BitKnitting/HappyDayNeighbors/Fusion360/rn2483-1.snapshot.1/RN2483.JPG

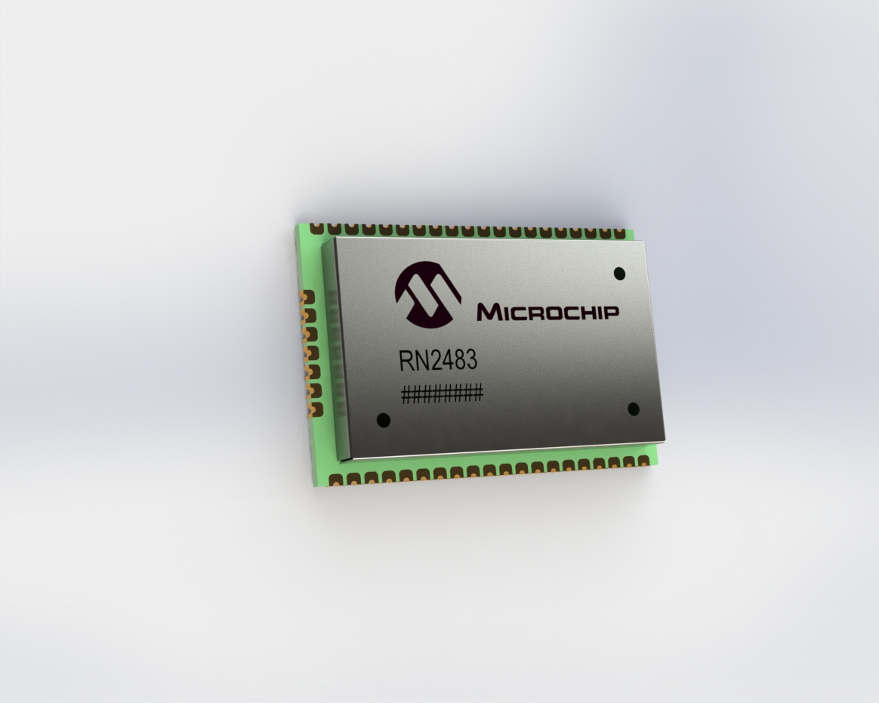
Fusion360/rn2483-1.snapshot.1/RN2483.JPG
