BitKnitting/HappyDayNeighbors/images/ATM90_Circuit.png

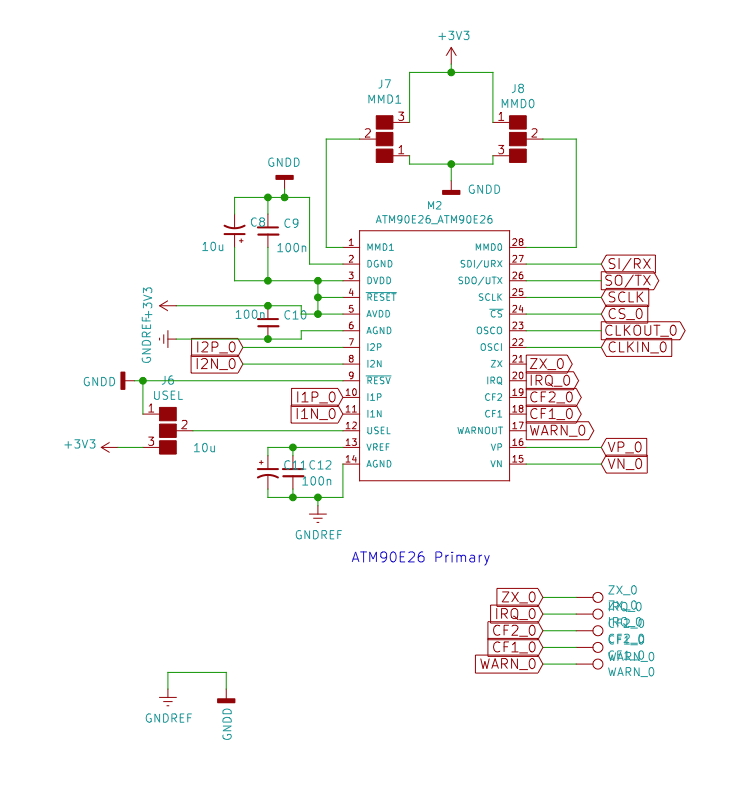
images/ATM90_Circuit.png
