BitKnitting/HappyDayNeighbors/images/AtMelAppNoteSchematic.png

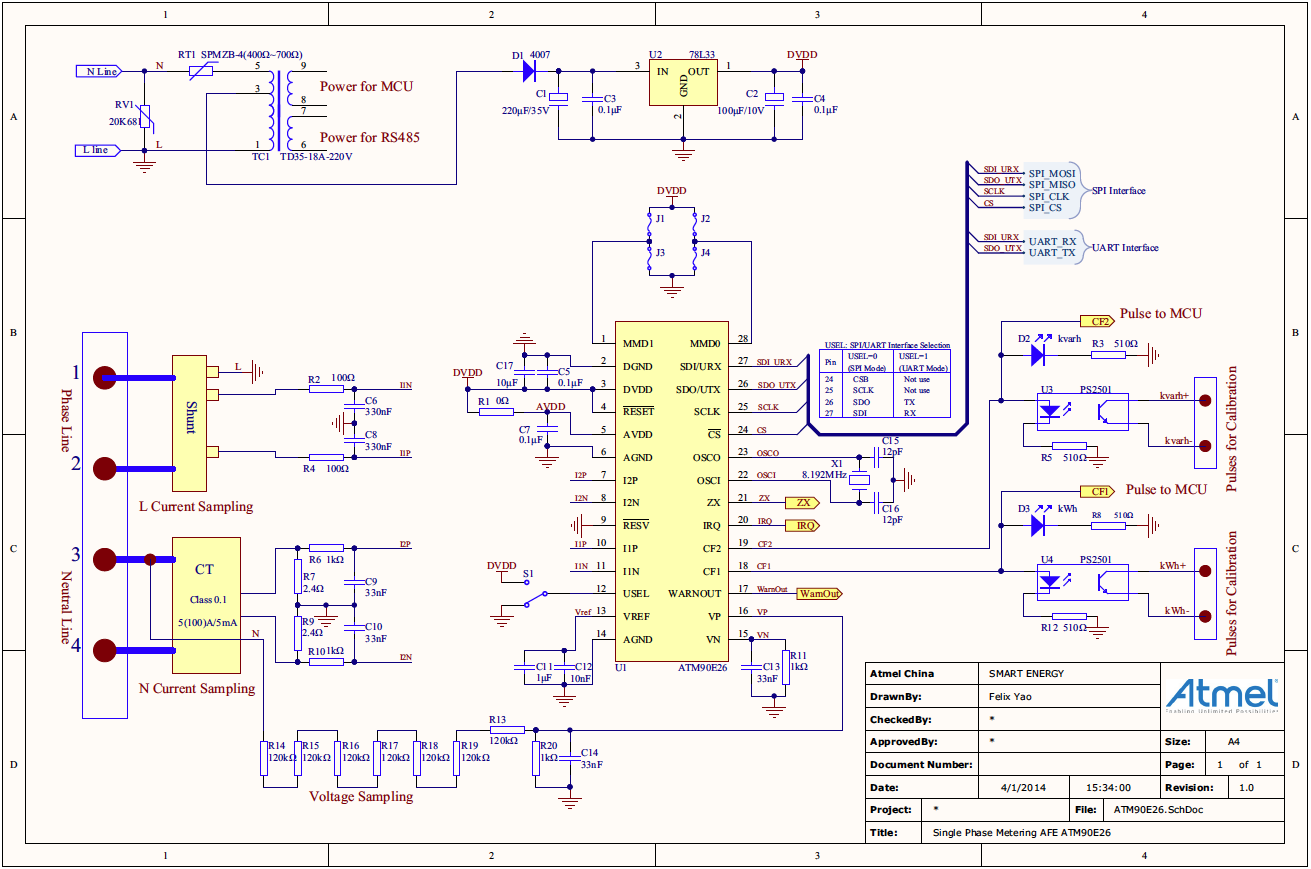
images/AtMelAppNoteSchematic.png
