BitKnitting/HappyDayNeighbors/images/din_power.png

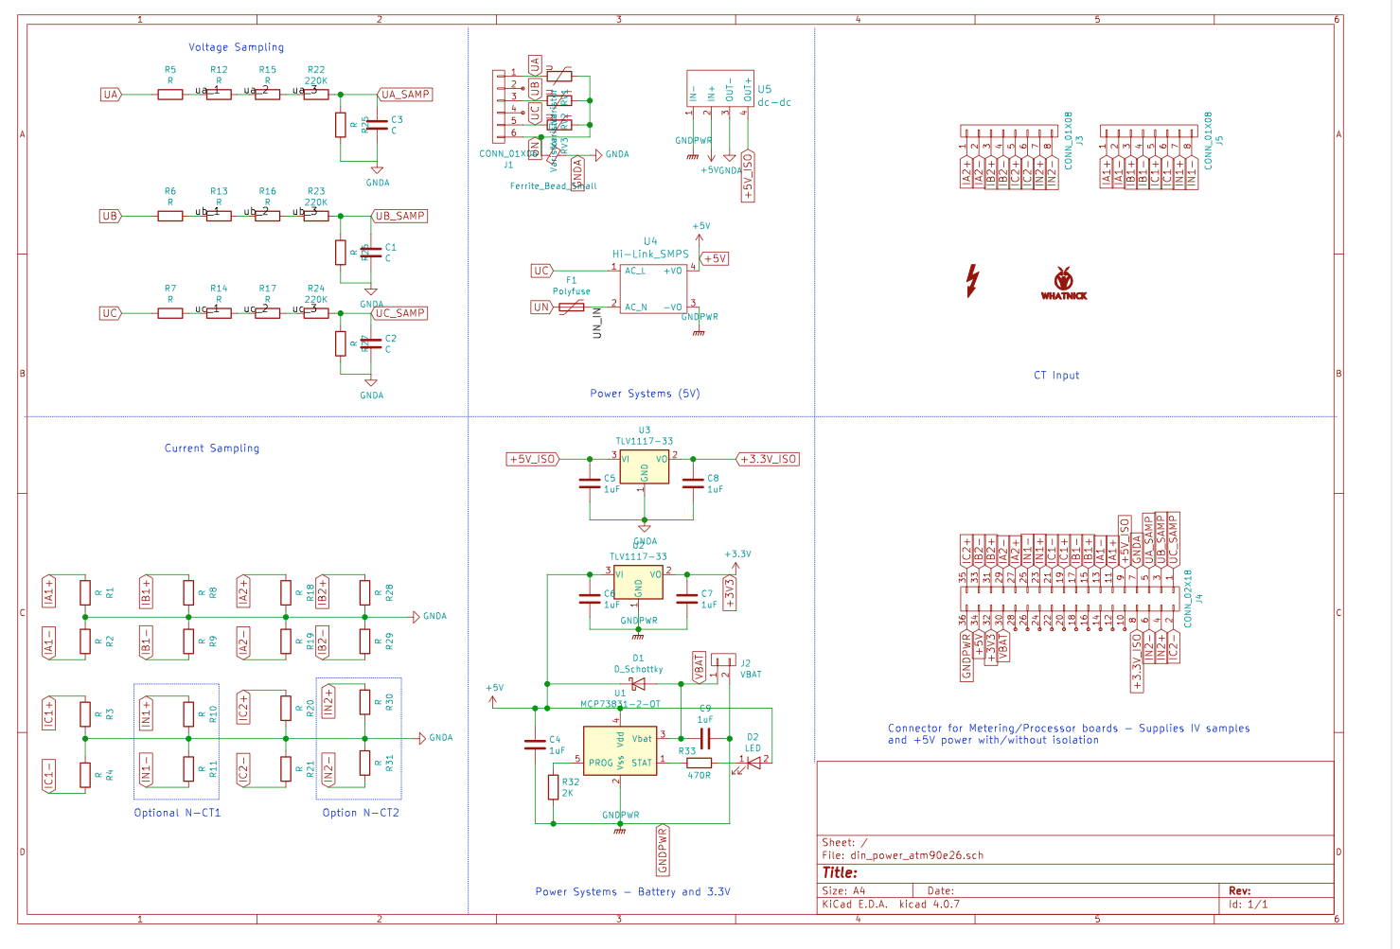
images/din_power.png
