BitKnitting/HappyDayNeighbors/images/HappyDay_IC_Schematic.png

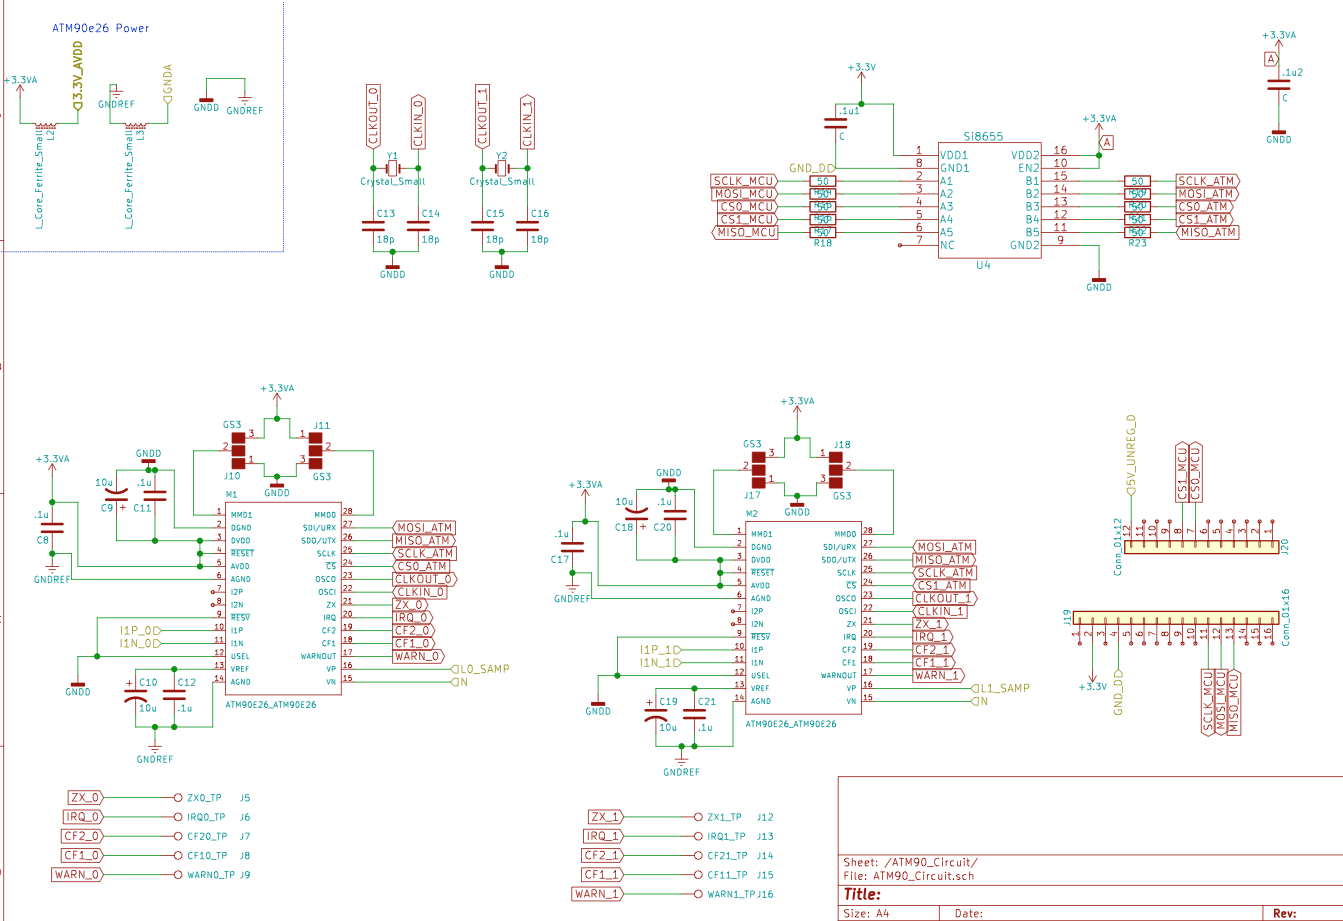
images/HappyDay_IC_Schematic.png
