BitKnitting/HappyDayNeighbors/images/HappyDay_Power_Schematic.png

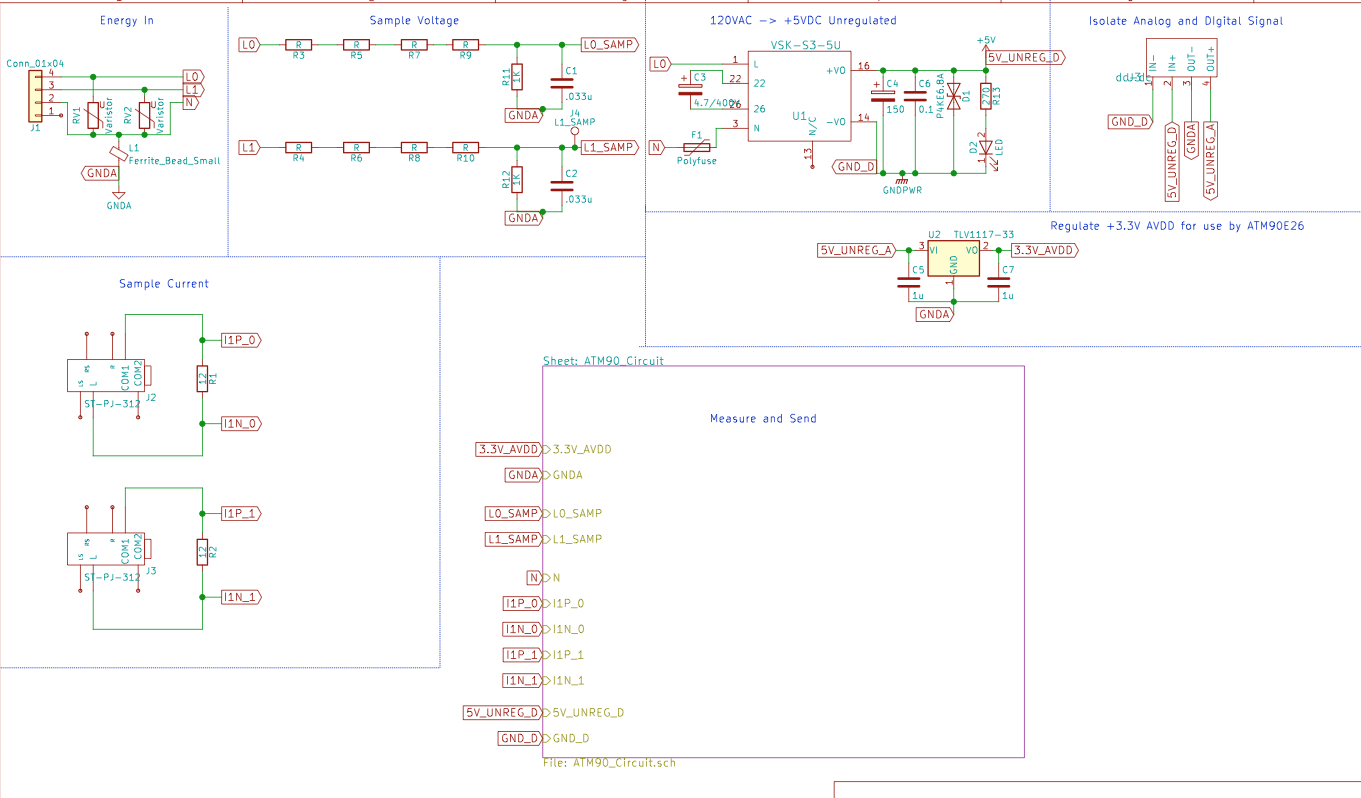
images/HappyDay_Power_Schematic.png
