BitKnitting/HappyDayNeighbors/images/Isolate_analog_and_digital.png

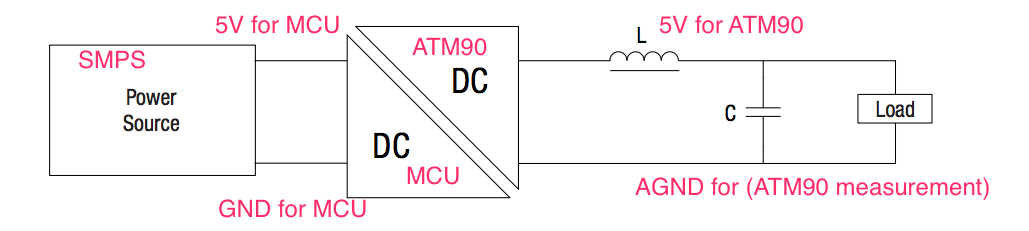
images/Isolate_analog_and_digital.png
