BitKnitting/HappyDayNeighbors/images/OEMPictureElectricityIntoHome.png

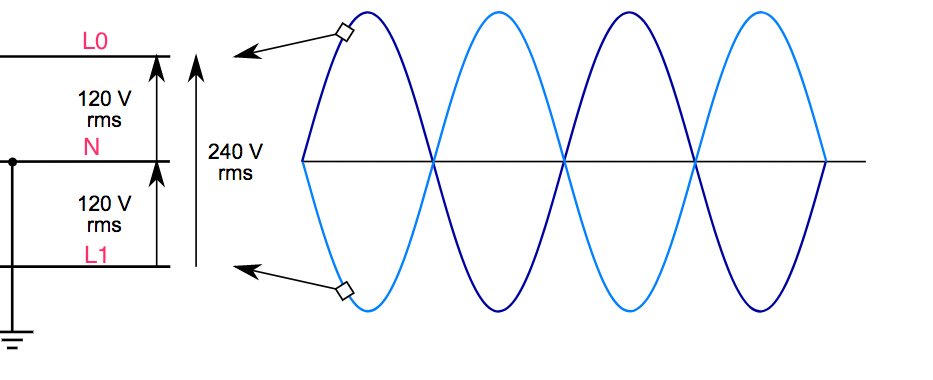
images/OEMPictureElectricityIntoHome.png
