BitKnitting/HappyDayNeighbors/images/ScopeTP3_TP2_LO_SAMP.bmp

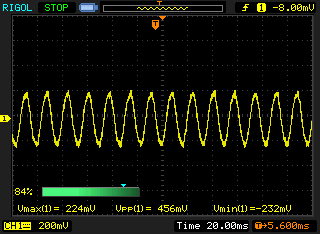
images/ScopeTP3_TP2_LO_SAMP.bmp
