BitKnitting/HappyDayNeighbors/Fusion360/rn2483-1.snapshot.1/RN2483.SLDASM

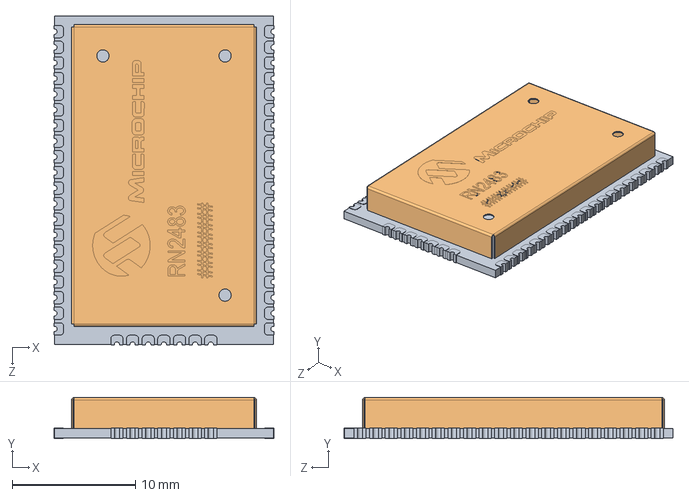
[picture p10: CAD file, 2017-12-04]
Fusion360/rn2483-1.snapshot.1/RN2483.SLDASM
17.9 x 3.35 x 26.7 mm
RN2483-PCB
RN2483-CAN
