BitKnitting/HappyDayNeighbors/Fusion360/rn2483-1.snapshot.1/RN2483-CAN.SLDPRT

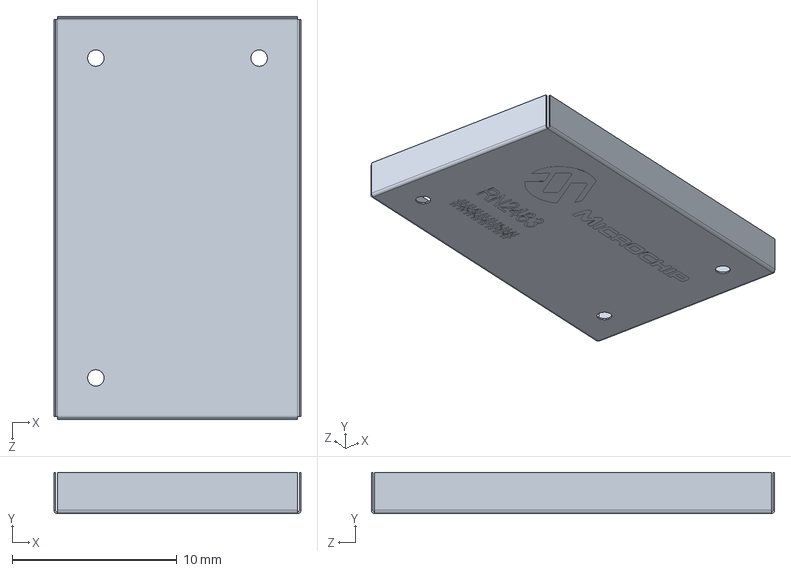
[picture p11: CAD file, 2017-12-04]
Fusion360/rn2483-1.snapshot.1/RN2483-CAN.SLDPRT
15.0 x 2.51 x 24.5 mm
