BitKnitting/HappyDayNeighbors/Fusion360/rn2483-1.snapshot.1/RN2483-PCB.SLDPRT

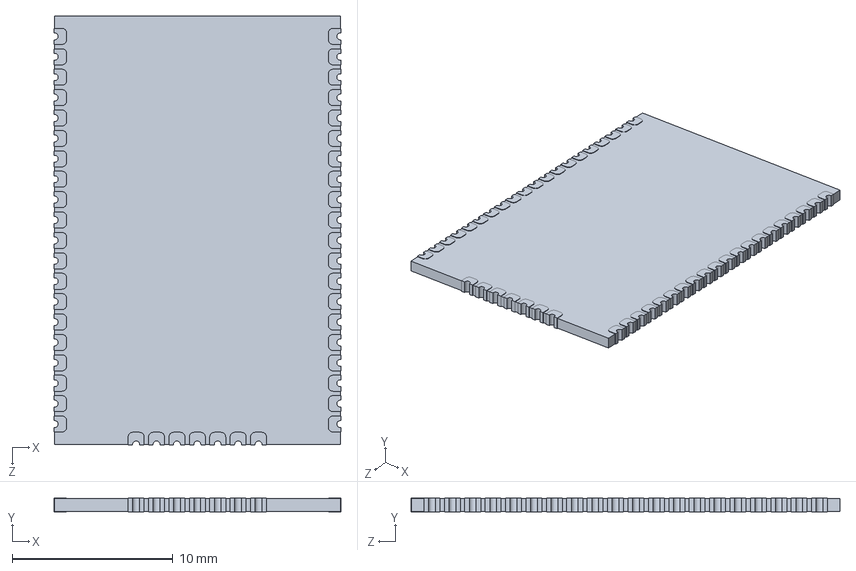
[picture p12: CAD file, 2017-12-04]
Fusion360/rn2483-1.snapshot.1/RN2483-PCB.SLDPRT
17.9 x 0.87 x 26.7 mm
