BitKnitting/HappyDayNeighbors/(list of files, cad)

Other CAD files:
Fusion360/rn2483-1.snapshot.1/RN2483.SLDDRW
