BitKnitting/HappyDayNeighbors/Tools/LogicAnalyzer/Images/ArdspiTestMeterStatusMISO.png

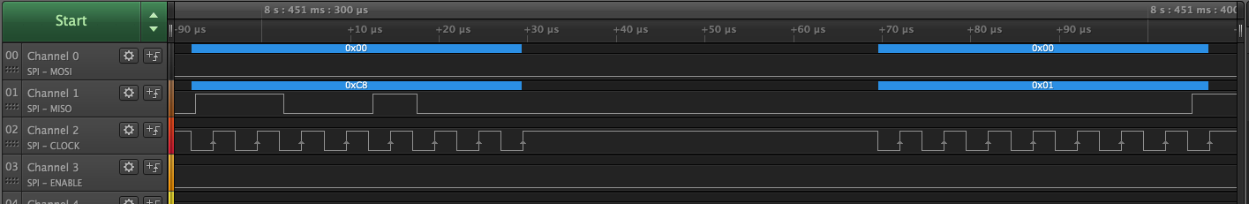
Tools/LogicAnalyzer/Images/ArdspiTestMeterStatusMISO.png
