BitKnitting/HappyDayNeighbors/Tools/LogicAnalyzer/Images/ArdspiTestMeterStatusMOSI.png

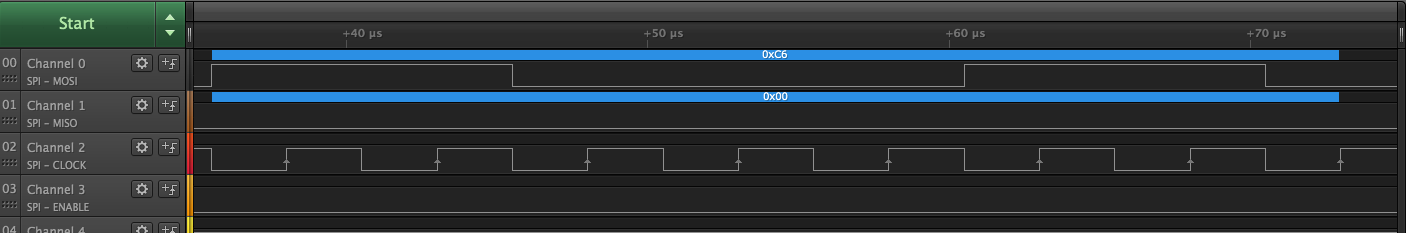
Tools/LogicAnalyzer/Images/ArdspiTestMeterStatusMOSI.png
