BitKnitting/HappyDayNeighbors/Tools/LogicAnalyzer/Images/PyspiTestMeterStatus.png

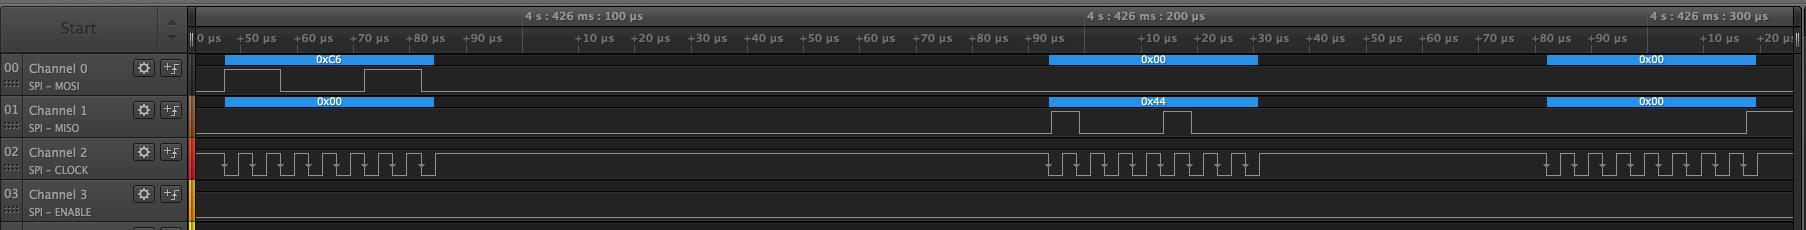
Tools/LogicAnalyzer/Images/PyspiTestMeterStatus.png
