BitKnitting/HappyDayNeighbors/HappyDay_Energy_PCB/HappyDay_Energy_PCB.kicad_pcb

## KiCad design HappyDay_Energy_PCB/HappyDay_Energy_PCB.kicad_pcb (2017-12-27)

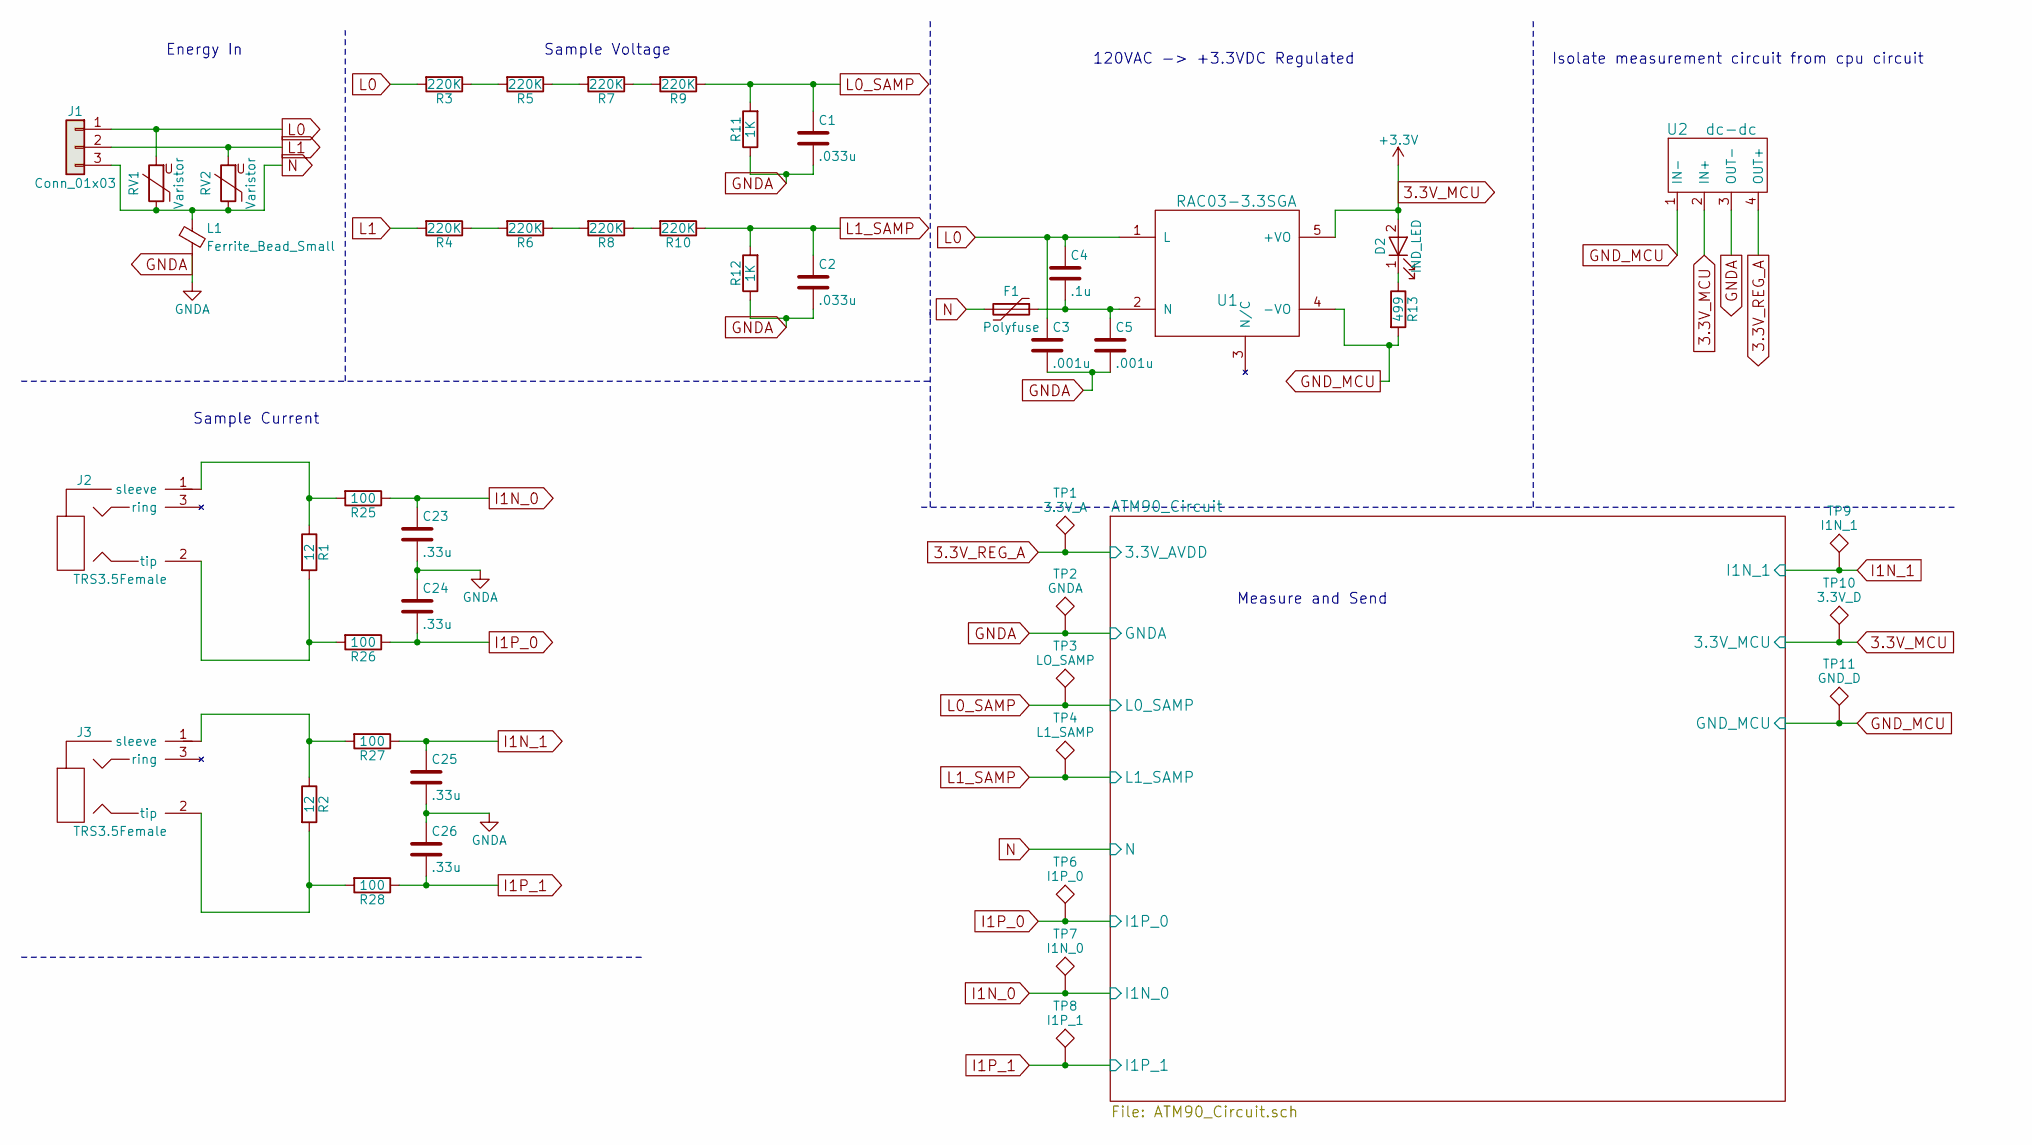
[picture p17: schematic HappyDay_Energy_PCB.sch]

Parts:
C1, C2: .033u; C_0805
C3, C5: .001u; C_0805
C4: .1u; C_0805
C23, C24, C25, C26: .33u; C_0805
D2: IND_LED; C_1206_HandSoldering
F1: Polyfuse; POLYFUSE
J1: Conn_01x03; 3PinConnector
J2, J3: TRS3.5Female; Audio-Jack
L1: Ferrite_Bead_Small; C_1206
R1, R2: 12; C_0805
R3, R4, R5, R6, R7, R8, R9, R10: 220K; C_1206
R11, R12: 1K; C_0805
R13: 499; C_0805
R25, R26, R27, R28: 100; C_0805
RV1, RV2: Varistor; MOV
TP1: 3.3V_A; Test_Point_Pad_d2.0mm
TP2: GNDA; Test_Point_Pad_d2.0mm
TP3: LO_SAMP; Test_Point_Pad_d2.0mm
TP4: L1_SAMP; Test_Point_Pad_d2.0mm
TP6: I1P_0; Test_Point_Pad_d2.0mm
TP7: I1N_0; Test_Point_Pad_d2.0mm
TP8: I1P_1; Test_Point_Pad_d2.0mm
TP9: I1N_1; Test_Point_Pad_d2.0mm
TP10: 3.3V_D; Test_Point_Pad_d2.0mm
TP11: GND_D; Test_Point_Pad_d2.0mm
U1: RAC03-3.3SGA; RAC03-GA
U2: dc-dc; DC-DC

Connections:
3.3V_MCU: D2.2 (A), TP10.1, U1.5 (+VO), U2.2 (IN+); also elsewhere on the board
3.3V_REG_A: TP1.1, U2.4 (OUT+); also elsewhere on the board
GNDA: C1.2, C2.2, C3.2, C5.2, C23.2, C24.1, C25.2, C26.1, L1.2, R11.1, R12.1, TP2.1, U2.3 (OUT-); also elsewhere on the board
GND_MCU: R13.2, TP11.1, U1.4 (-VO), U2.1 (IN-); also elsewhere on the board
I1N_0: C23.1, R25.1, TP7.1; also elsewhere on the board
I1N_1: C25.1, R27.1, TP9.1; also elsewhere on the board
I1P_0: C24.2, R26.1, TP6.1; also elsewhere on the board
I1P_1: C26.2, R28.1, TP8.1; also elsewhere on the board
L0: C3.1, C4.1, J1.1, R3.2, RV1.2, U1.1 (L)
L0_SAMP: C1.1, R9.1, R11.2, TP3.1; also elsewhere on the board
L1: J1.2, R4.2, RV2.2
L1_SAMP: C2.1, R10.1, R12.2, TP4.1; also elsewhere on the board
N: F1.2, J1.3, L1.1, RV1.1, RV2.1; also elsewhere on the board
unnamed: C4.2, C5.1, F1.1, U1.2 (N)
unnamed: D2.1 (K), R13.1
unnamed: J2.1 (sleeve), R1.1, R25.2
unnamed: J2.2 (tip), R1.2, R26.2
unnamed: J3.1 (sleeve), R2.1, R27.2
unnamed: J3.2 (tip), R2.2, R28.2
unnamed: R3.1, R5.2
unnamed: R4.1, R6.2
unnamed: R5.1, R7.2
unnamed: R6.1, R8.2
unnamed: R7.1, R9.2
unnamed: R8.1, R10.2

Notes on the sheet:
Energy In
Sample Voltage
Sample Current
120VAC -> +3.3VDC Regulated
Isolate measurement circuit from cpu circuit
Measure and Send

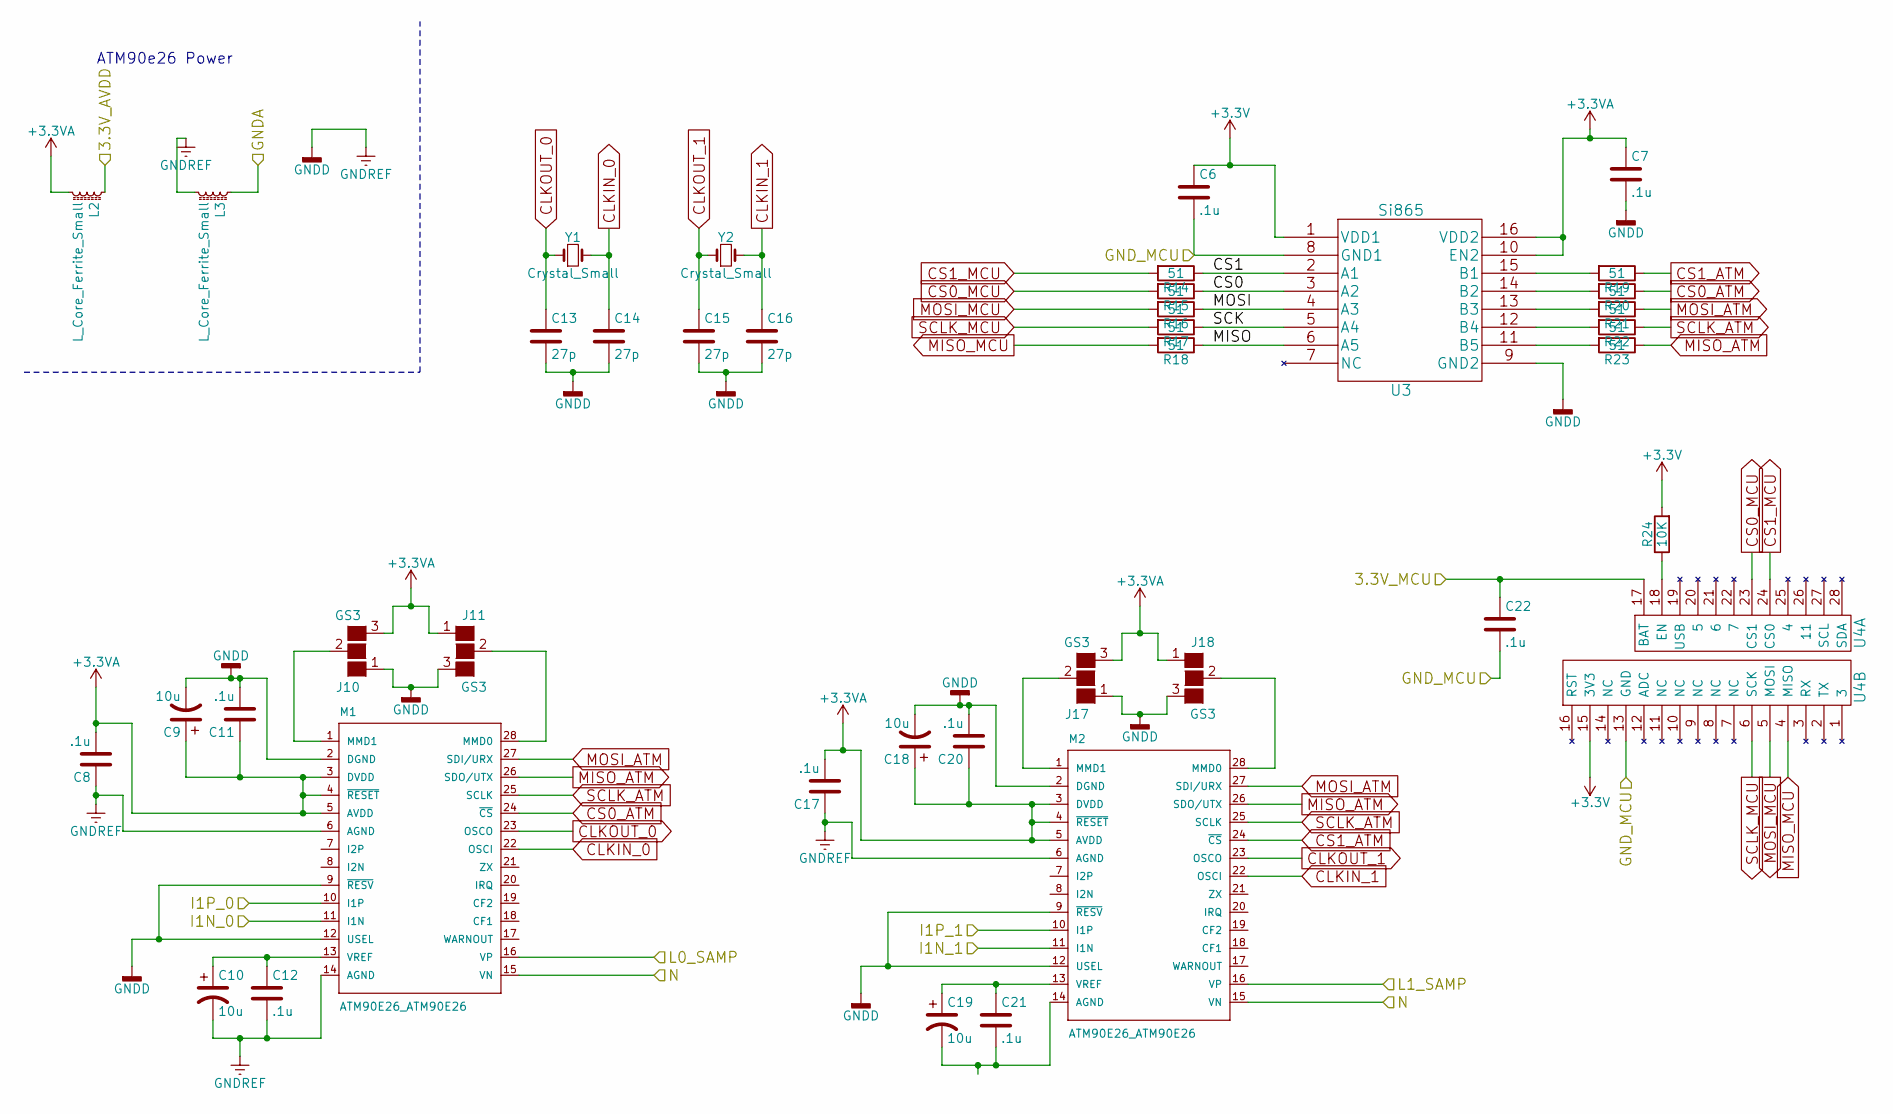
[picture p18: schematic ATM90_Circuit.sch]

Parts:
C6, C7, C8, C11, C12, C17, C20, C21, C22: .1u; C_0805
C9, C10, C18, C19: 10u; C_0805
C13, C14, C15, C16: 27p; C_0805
J10, J11, J17, J18: GS3
L2, L3: L_Core_Ferrite_Small; C_0805
M1, M2: ATM90E26_ATM90E26; SSOP-28_5.3x10.2mm_Pitch0.65mm
R14, R15, R16, R17, R18, R19, R20, R21, R22, R23: 51; C_0805
R24: 10K; C_0805
U3: Si865
U4: FeatherHuzzah; ADAFRUIT_FEATHER
Y1, Y2: Crystal_Small; Crystal

Connections:
3.3V_MCU: C6.1, C22.1, R24.2, U3.1 (VDD1), U4.15 (3V3), U4.17 (BAT); also elsewhere on the board
3.3V_REG_A: L2.1; also elsewhere on the board
+3.3VA: C7.1, C8.2, C9.1, C11.1, C17.2, C18.1, C20.1, J10.3 (G3), J11.1 (G1), J17.3 (G3), J18.1 (G1), L2.2, M1.3 (DVDD), M1.4 (~RESET), M1.5 (AVDD), M2.3 (DVDD), M2.4 (~RESET), M2.5 (AVDD), U3.10 (EN2), U3.16 (VDD2)
/ATM90_Circuit/CS0: R15.1, U3.3 (A2)
/ATM90_Circuit/CS1: R14.1, U3.2 (A1)
/ATM90_Circuit/MISO: R18.1, U3.6 (A5)
/ATM90_Circuit/MOSI: R16.1, U3.4 (A3)
/ATM90_Circuit/SCK: R17.1, U3.5 (A4)
CLKIN_0: C14.1, M1.22 (OSCI), Y1.2
CLKIN_1: C16.1, M2.22 (OSCI), Y2.2
CLKOUT_0: C13.1, M1.23 (OSCO), Y1.1
CLKOUT_1: C15.1, M2.23 (OSCO), Y2.1
CS0_ATM: M1.24 (~CS), R20.1
CS0_MCU: R15.2, U4.23 (CS1)
CS1_ATM: M2.24 (~CS), R19.1
CS1_MCU: R14.2, U4.24 (CS0)
GNDA: L3.1; also elsewhere on the board
GNDD: C7.2, C8.1, C9.2, C10.2, C11.2, C12.2, C13.2, C14.2, C15.2, C16.2, C17.1, C18.2, C20.2, J10.1 (G1), J11.3 (G3), J17.1 (G1), J18.3 (G3), L3.2, M1.2 (DGND), M1.6 (AGND), M1.9 (~RESV), M1.12 (USEL), M1.14 (AGND), M2.2 (DGND), M2.6 (AGND), M2.9 (~RESV), M2.12 (USEL), U3.9 (GND2)
GND_MCU: C6.2, C22.2, U3.8 (GND1), U4.13 (GND); also elsewhere on the board
I1N_0: M1.11 (I1N); also elsewhere on the board
I1N_1: M2.11 (I1N); also elsewhere on the board
I1P_0: M1.10 (I1P); also elsewhere on the board
I1P_1: M2.10 (I1P); also elsewhere on the board
L0_SAMP: M1.16 (VP); also elsewhere on the board
L1_SAMP: M2.16 (VP); also elsewhere on the board
MISO_ATM: M1.26 (SDO/UTX), M2.26 (SDO/UTX), R23.1
MISO_MCU: R18.2, U4.4 (MISO)
MOSI_ATM: M1.27 (SDI/URX), M2.27 (SDI/URX), R21.1
MOSI_MCU: R16.2, U4.5 (MOSI)
N: M1.15 (VN), M2.15 (VN); also elsewhere on the board
unnamed: C10.1, C12.1, M1.13 (VREF)
unnamed: C19.1, C21.1, M2.13 (VREF)
unnamed: C19.2, C21.2, M2.14 (AGND)
unnamed: J10.2 (G2), M1.1 (MMD1)
unnamed: J11.2 (G2), M1.28 (MMD0)
unnamed: J17.2 (G2), M2.1 (MMD1)
unnamed: J18.2 (G2), M2.28 (MMD0)
unnamed: R19.2, U3.15 (B1)
unnamed: R20.2, U3.14 (B2)
unnamed: R21.2, U3.13 (B3)
unnamed: R22.2, U3.12 (B4)
unnamed: R23.2, U3.11 (B5)
unnamed: R24.1, U4.18 (EN)
SCLK_ATM: M1.25 (SCLK), M2.25 (SCLK), R22.1
SCLK_MCU: R17.2, U4.6 (SCK)

Notes on the sheet:
ATM90e26 Power

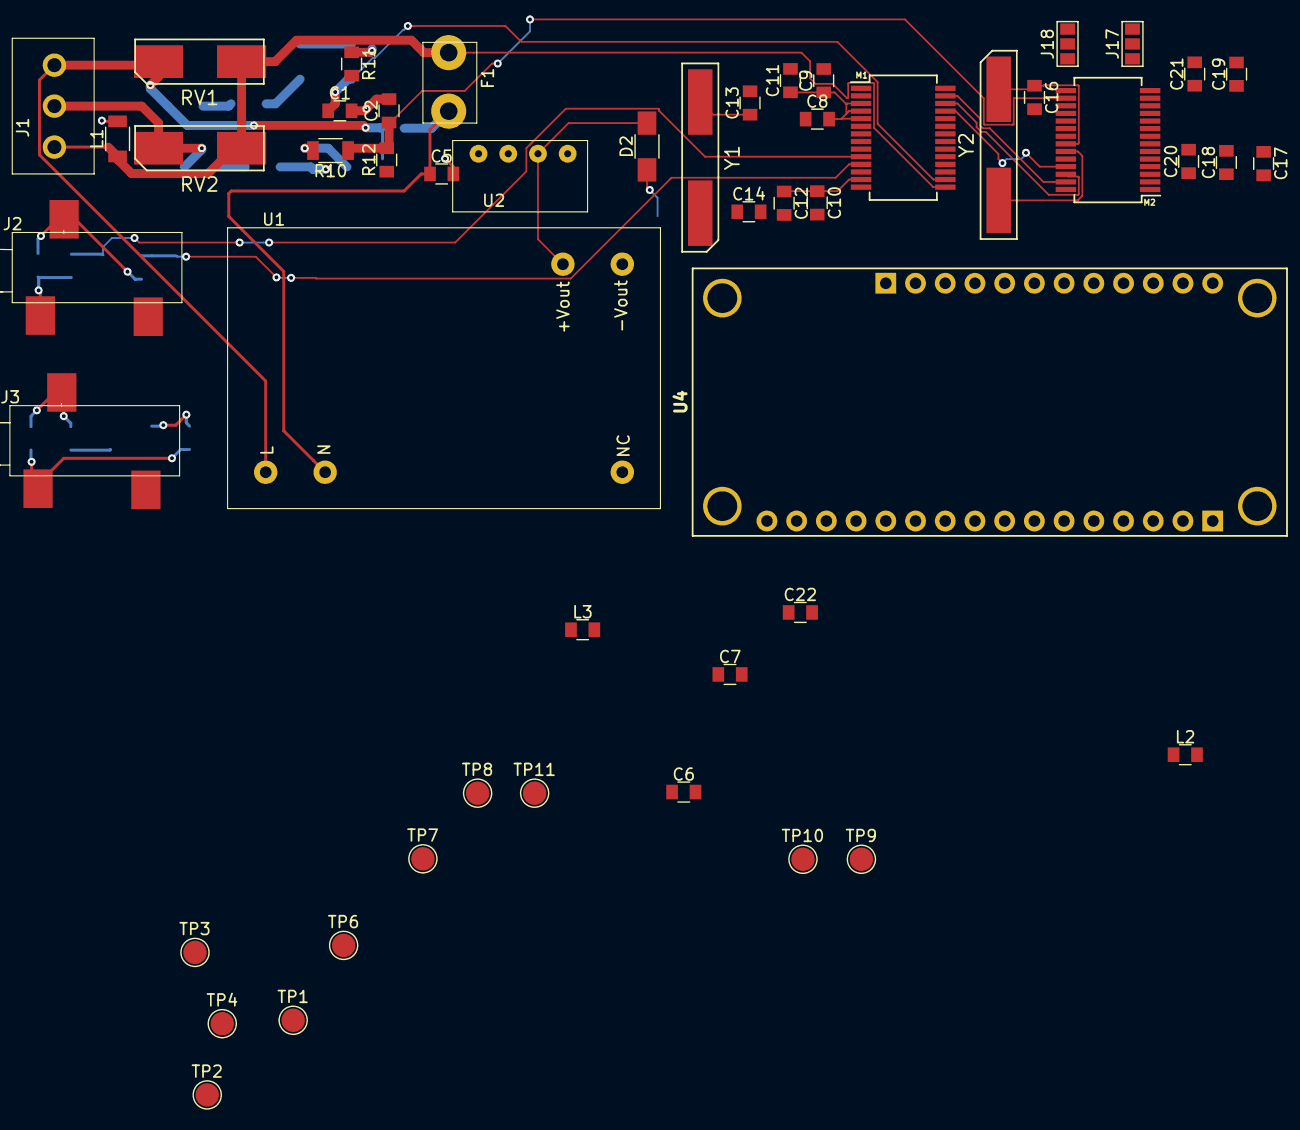
[picture p19: board HappyDay_Energy_PCB.kicad_pcb from above]

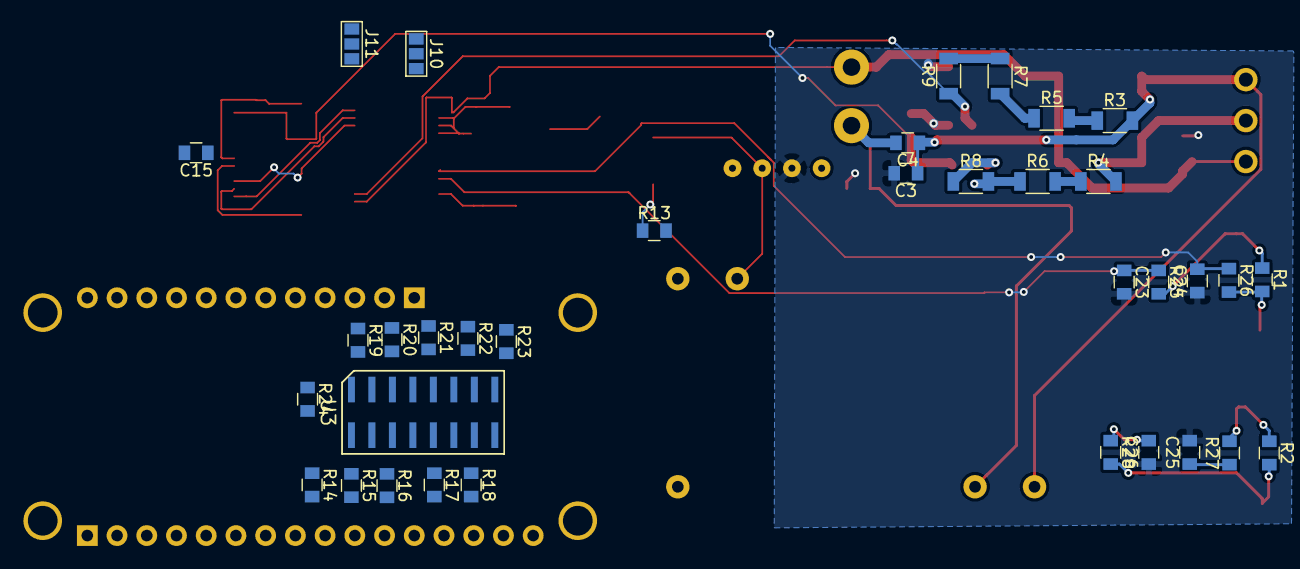
[picture p20: board HappyDay_Energy_PCB.kicad_pcb from below]

Board: 2 copper layers, 86 parts (35 on the bottom side), 59 nets.
