BitKnitting/HappyDayNeighbors/Python/refresh_Huzzah/HappyDay_energyic_spi.py

# The MIT License (MIT)
#
# Copyright (c) 2017 HappyDay
#
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
# THE SOFTWARE IS PROVIDED "AS IS", WITHOUT WARRANTY OF ANY KIND, EXPRESS OR
# IMPLIED, INCLUDING BUT NOT LIMITED TO THE WARRANTIES OF MERCHANTABILITY,
# FITNESS FOR A PARTICULAR PURPOSE AND NONINFRINGEMENT. IN NO EVENT SHALL THE
# AUTHORS OR COPYRIGHT HOLDERS BE LIABLE FOR ANY CLAIM, DAMAGES OR OTHER
# LIABILITY, WHETHER IN AN ACTION OF CONTRACT, TORT OR OTHERWISE, ARISING FROM,
# OUT OF OR IN CONNECTION WITH THE SOFTWARE OR THE USE OR OTHER DEALINGS IN
# THE SOFTWARE.
"""
`HappyDay_energyic_SPI`
====================================================

This is a CircuitPython driver for the ATM90e26 energy reading chip.

* Author(s): HappyDay ported the energyic_SPI.cpp Arduino library by whatnick and
             Ryzee (c 2016).  The energyic_SPI.cpp library is located at this GitHub location:
             https://github.com/whatnick/ATM90E26_Arduino/blob/master/energyic_SPI.cpp
             The HappyDay port is copyright 2017.

"""
#### REGISTERS #####
ATM90_SysStatus    = const(0x01)  # System Status
ATM90_SoftReset    = const(0x00)  # Software Reset
ATM90_FuncEn       = const(0x02)  # Function Enable
ATM90_SagTh        = const(0x03)  # Voltage Sag Threshold
ATM90_CalStart     = const(0x20)  # Calibration Start Command
ATM90_PLconstH     = const(0x21)  # High Word of PL_Constant
ATM90_PLconstL     = const(0x22)  # Low Word of PL_Constant
ATM90_Lgain        = const(0x23)  # L Line Calibration Gain
ATM90_Lphi         = const(0x24)  # L Line Calibration Angle
ATM90_Ngain        = const(0x25)  # N Line Calibration Gain
ATM90_Nphi         = const(0x26)  # N Line Calibration Angle
ATM90_PStartTh     = const(0x27)  # Active Startup Power Threshold
ATM90_PNolTh       = const(0x28)  # Active No-Load Power Threshold
ATM90_QStartTh     = const(0x29)  # Reactive Startup Power Threshold
ATM90_QNolTh       = const(0x2A)  # Reactive No-Load Power Threshold
ATM90_MMode        = const(0x2B)  # Metering Mode Configuration
ATM90_CSOne        = const(0x2C)  # Checksum 1
ATM90_AdjStart     = const(0x30)  # Measurement calibration startup command, registers 31-3A
ATM90_Ugain        = const(0x31)  # Voltage rms Gain
ATM90_IgainL       = const(0x32)  # L Line Current rms Gain
ATM90_Uoffset      = const(0x34)  # Voltage Offset
ATM90_IoffsetL     = const(0x35)  # L line current offset
ATM90_PoffsetL     = const(0x37)  # L Line Active Power Offset
ATM90_QoffsetL     = const(0x38)  # L Line Reactive Power Offset
ATM90_CSTwo        = const(0x3B)  # Checksum 2
ATM90_EnStatus     = const(0x46)  # Metering Status
ATM90_Urms         = const(0x49)  # Voltage rms
ATM90_Irms         = const(0x48)  # L Line Current rms
ATM90_Pmean        = const(0x4A)  # L Line Mean Active Power
ATM90_PowerF       = const(0x4D)  # L Line Power Factor
ATM90_Freq         = const(0x4C)  # Voltage frequency
ATM90_APenergy     = const(0x40)  # Forward Active Energy
ATM90_ANenergy     = const(0x41)  # Reverse Active Energy

import time # need a bit of delay at the end of initializing the ATM90e26...
import board
import busio
import digitalio
from spi_device import SPIDevice

class energyic_SPI:
    ##############################################################################

    def __init__(self,spi_bus,cs):
        self._device = SPIDevice(spi_bus,cs,baudrate=200000,polarity=1,phase=1)

    def initEnergyIC(self):
        # Perform soft reset
        self._commEnergyIC(0,ATM90_SoftReset,0x789A)
        # Voltage sag irq=1, report on warnout pin=1, energy dir change irq=0
        self._commEnergyIC(0,ATM90_FuncEn,0x0030)
        # Voltage sag threshhold
        self._commEnergyIC(0,ATM90_SagTh,0x1F2F)
        #########################################
        #### Set metering calibration values ####
        #########################################
        # Metering calibration startup command. Register 21 to 2B need to be set
        self._commEnergyIC(0,ATM90_CalStart,0x5678)
        # PL Constant MSB
        self._commEnergyIC(0,ATM90_PLconstH,0x00B9)
        # PL Constant LSB
        self._commEnergyIC(0,ATM90_PLconstL,0xC1F3)
        # Line calibration gain
        self._commEnergyIC(0,ATM90_Lgain,0x1D39)
        # Line calibration angle
        self._commEnergyIC(0,ATM90_Lphi,0x0000)
        # Active Startup Power Threshold
        self._commEnergyIC(0,ATM90_PStartTh,0x08BD)
        # Active No-Load Power Threshold
        self._commEnergyIC(0,ATM90_PNolTh,0x0000)
        # Reactive Startup Power Threshold
        self._commEnergyIC(0,ATM90_QStartTh,0x0AEC)
        # Reactive No-Load Power Threshold
        self._commEnergyIC(0,ATM90_QNolTh,0x0000)
        # Metering Mode Configuration. All defaults. See pg 3
        self._commEnergyIC(0,ATM90_MMode,0x9422)
        # Write CSOne, as self calculated
        self._commEnergyIC(0,ATM90_CSOne,0x4A34)
        #checksum = self._commEnergyIC(1,ATM90_CSOne,0x0000)
        #print('Checksum 1: ',hex(checksum))
        ##############################################
        # Set measurement calibration values
        ##############################################
        self._commEnergyIC(0,ATM90_AdjStart,0x5678)
        #!!!!!!!!!!!!!!!!!!!!!!!!!!!!!!!!!!!!!!!!!!!!!!!!!!!!!!!!!!!!!!!!!!!!!!!!!!!!!!!!!!!
        ### !!!!! Modified Ugain.  See my bitknitting post on this:
        # https://bitknitting.wordpress.com/2017/10/07/trying-out-the-atm90e26-featherwing/
        #!!!!!!!!!!!!!!!!!!!!!!!!!!!!!!!!!!!!!!!!!!!!!!!!!!!!!!!!!!!!!!!!!!!!!!!!!!!!!!!!!!!
        self._commEnergyIC(0,ATM90_Ugain,0x890F)
        # L line current gain
        self._commEnergyIC(0,ATM90_IgainL,0x6E49)
        # Voltage offset
        self._commEnergyIC(0,ATM90_Uoffset,0x0000)
        # L line current offset
        self._commEnergyIC(0,ATM90_IoffsetL,0x0000)
        # L line active power offset
        self._commEnergyIC(0,ATM90_PoffsetL,0x0000)
        # L line reactive power offset
        self._commEnergyIC(0,ATM90_QoffsetL,0x0000)
        #!!!!!!!!!!!!!!!!!!!!!!!!!!!!!!!!!!!!!!!!!!!!!!!!!!!!!!!!!!!!!!!!!!!!!!!!!!!!!!!!!!!
        ### !!!!! Modified Checksum two.  See my bitknitting post on this:
        # https://bitknitting.wordpress.com/2017/10/07/trying-out-the-atm90e26-featherwing/
        #!!!!!!!!!!!!!!!!!!!!!!!!!!!!!!!!!!!!!!!!!!!!!!!!!!!!!!!!!!!!!!!!!!!!!!!!!!!!!!!!!!!
        self._commEnergyIC(0,ATM90_CSTwo,0xE4F4)
        #checksum = self._commEnergyIC(1,ATM90_CSTwo,0x0000)
        #print('Checksum 2: ',hex(checksum))
        # Checks correctness of 21-2B registers and starts normal metering if ok
        self._commEnergyIC(0,ATM90_CalStart,0x8765)
        # Checks correctness of 31-3A registers and starts normal measurement  if ok
        self._commEnergyIC(0,ATM90_AdjStart,0x8765)
        time.sleep(2) # the chip needs a couple of secs to get it's act together.....
        #####################################################################################
    def getSysStatus(self):
        reading = self._commEnergyIC(1,ATM90_SysStatus,0xFFFF)
        return reading
        #####################################################################################
    def getMeterStatus(self):
        reading = self._commEnergyIC(1,ATM90_EnStatus,0xFFFF)
        return reading
        #####################################################################################
    def getLineVoltage(self):
        reading = self._commEnergyIC(1,ATM90_Urms,0xFFFF)
        reading = reading/100.0
        return reading
        #####################################################################################
    def getLineCurrent(self):
        reading = self._commEnergyIC(1,ATM90_Irms,0xFFFF)
        print("line current: ",reading)
        reading = reading/1000
        return reading
        #####################################################################################
    def getActivePower(self):
        reading = self._commEnergyIC(1,ATM90_Pmean,0xFFFF)
        return reading
        #####################################################################################
    def getPowerFactor(self):
        reading = self._commEnergyIC(1,ATM90_PowerF,0xFFFF)
        # MSB is signed bit...if negative...
        if (reading & 0x8000):
            reading = (reading & 0x7FFF) * -1
        return reading/1000
        #####################################################################################
    def getFrequency(self):
        reading = self._commEnergyIC(1,ATM90_Freq,0xFFFF)
        return reading/100
        #####################################################################################
    def getImportEnergy(self):
        reading = self._commEnergyIC(1,ATM90_APenergy,0xFFFF)
        return reading * 0.0001 # returns kWh if PL constant set to 1000imp/kWh
        #####################################################################################
    def getExportEnergy(self):
        reading = self._commEnergyIC(1,ATM90_ANenergy,0xFFFF)
        return reading * 0.0001 # returns kWh if PL constant set to 1000imp/kWh
        #####################################################################################
    def _commEnergyIC(self,RW,address,value):
        #####################################################################################
        # If RW = Read, There needs to be a 1 in the highest bit of the address
        address |= RW << 7
        # The Arduino library put us sleeps in...I was getting correct results without adding sleeps???
        #usleep = lambda x: time.sleep(x/1000000.0)
        if (RW):
            bytes_read = bytearray(2)
            with self._device as spi:
                # delays were in the Arduino library
                #usleep(10)
                spi.write(bytearray([address]))
                # from Arduino lib: "Must wait 4 us for data to become valid"
                #usleep(4)
                spi.readinto(bytes_read)
                if bytes_read[0] == 0xff:  # The CT is facing the wrong way...
                    return -1
                intValue = int.from_bytes(bytes_read,'big',True)
                return intValue
        else: # Write the two bytes of the value.
            first_byte = value>>8
            with self._device as spi:
                #usleep(10)
                spi.write(bytearray([address]))
                #usleep(4)
                spi.write(bytearray([first_byte]))
                spi.write(bytearray([value]))
