BitKnitting/HappyDayNeighbors/(commit log)

2017-11-20 added PCB schematic sacrificial draft
    [ATM90_Circuit.sch, HappyDay_Energy_PCB.kicad_pcb, HappyDay_Energy_PCB.sch]
2017-11-24 sacrificial draft of power section / HappyDay Energy Monitor Schematic
    [ATM90_Circuit.sch, HappyDay_Energy_PCB.sch]
2017-11-24 evolved schematic
    [ATM90_Circuit.sch, HappyDay_Energy_PCB.sch]
2017-12-04 evolved layout
    [ATM90_Circuit.sch, HappyDay_Energy_PCB.csv, HappyDay_Energy_PCB.kicad_pcb, HappyDay_Energy_PCB.sch, JBParts.csv, MadeDigikeyBOM.csv, RN2483-CAN.SLDPRT, RN2483-PCB.SLDPRT]
2017-12-05 Kicad PCB sent to OSH Park
    [ATM90_Circuit.sch, HappyDay_Energy_PCB.kicad_pcb]
2017-12-07 files sent to OSH Park for sacrificial draft build
    [ATM90_Circuit.sch, HappyDay_Energy_PCB.csv, HappyDay_Energy_PCB.sch, JBParts.csv, MadeDigikeyBOM.csv]
2017-12-17 added a css file
    [HappyDay_Energy_PCB.sch]
2017-12-27 updates, particularly to layout - but not finished
    [ATM90_Circuit.sch, BoMparts.csv, HappyDay_Energy_PCB.csv, HappyDay_Energy_PCB.kicad_pcb, HappyDay_Energy_PCB.sch, JBParts.csv, MadeBOMfile.csv]
